Engineering-Capstone-TTE-Communications/TTE_Communications/GUI/Utilities/butts.png

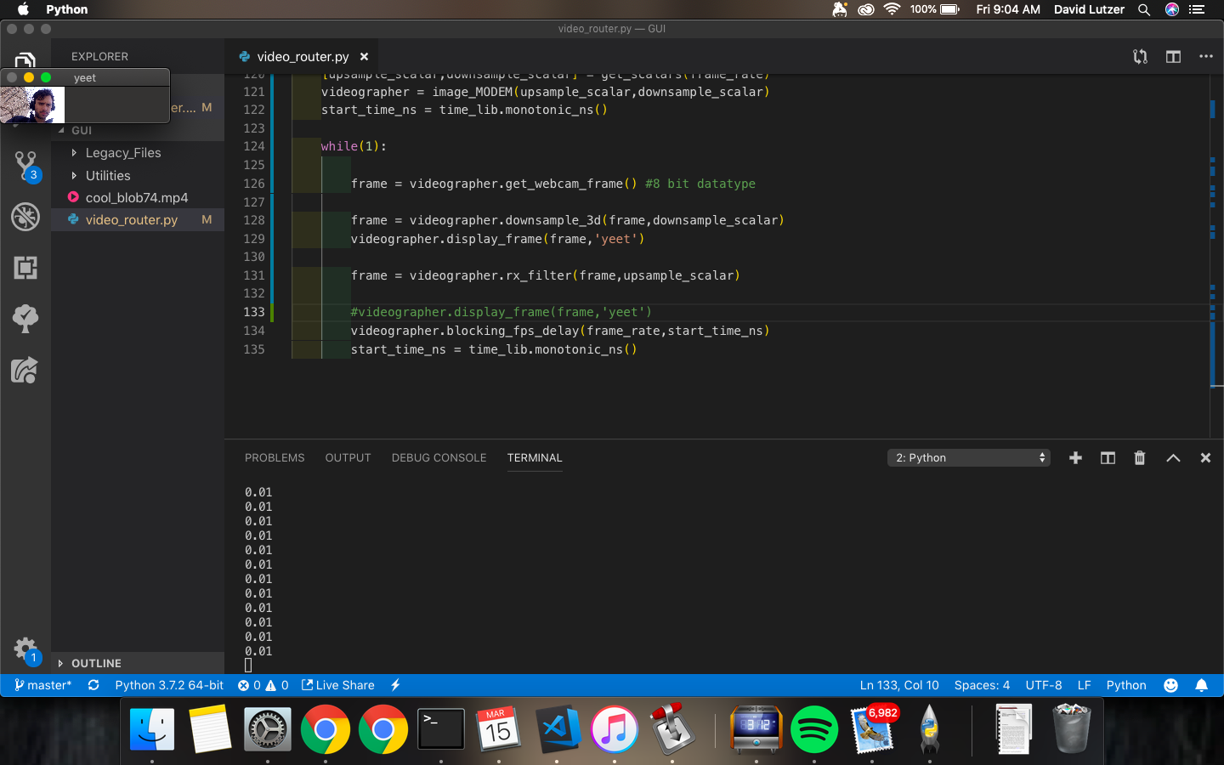
GUI/Utilities/butts.png
