Engineering-Capstone-TTE-Communications/TTE_Communications/GUI/Utilities/download.jpeg

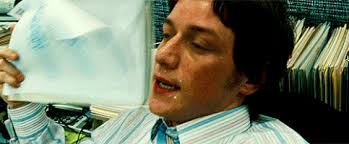
GUI/Utilities/download.jpeg
