Engineering-Capstone-TTE-Communications/TTE_Communications/MODEM_Code/arduino/ADC_Example.ino/aaa.bmp

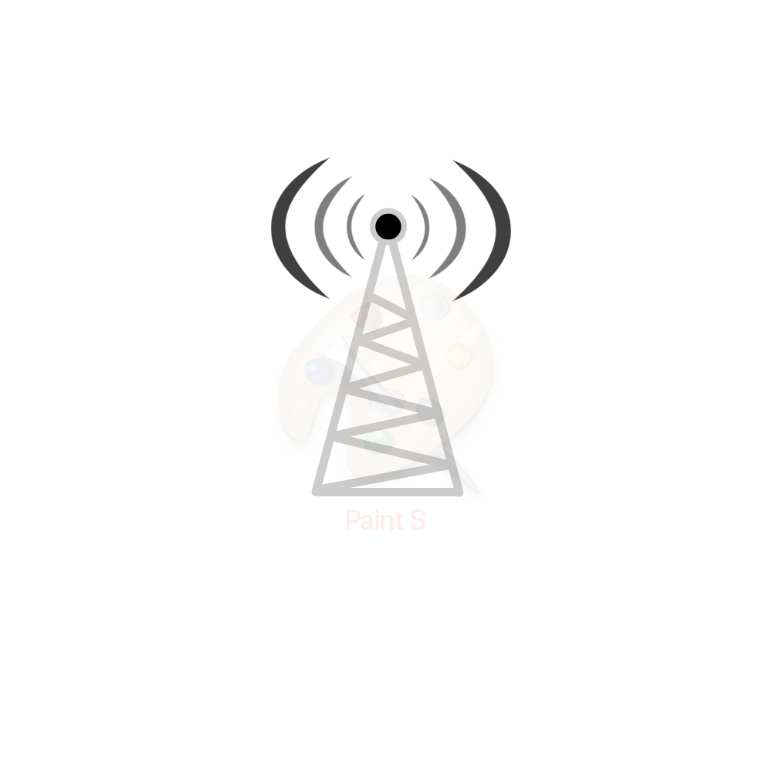
MODEM_Code/arduino/ADC_Example.ino/aaa.bmp
