Engineering-Capstone-TTE-Communications/TTE_Communications/MODEM_Code/arduino/ADC_Example.ino/ADC_DAC_Circuit.jpg

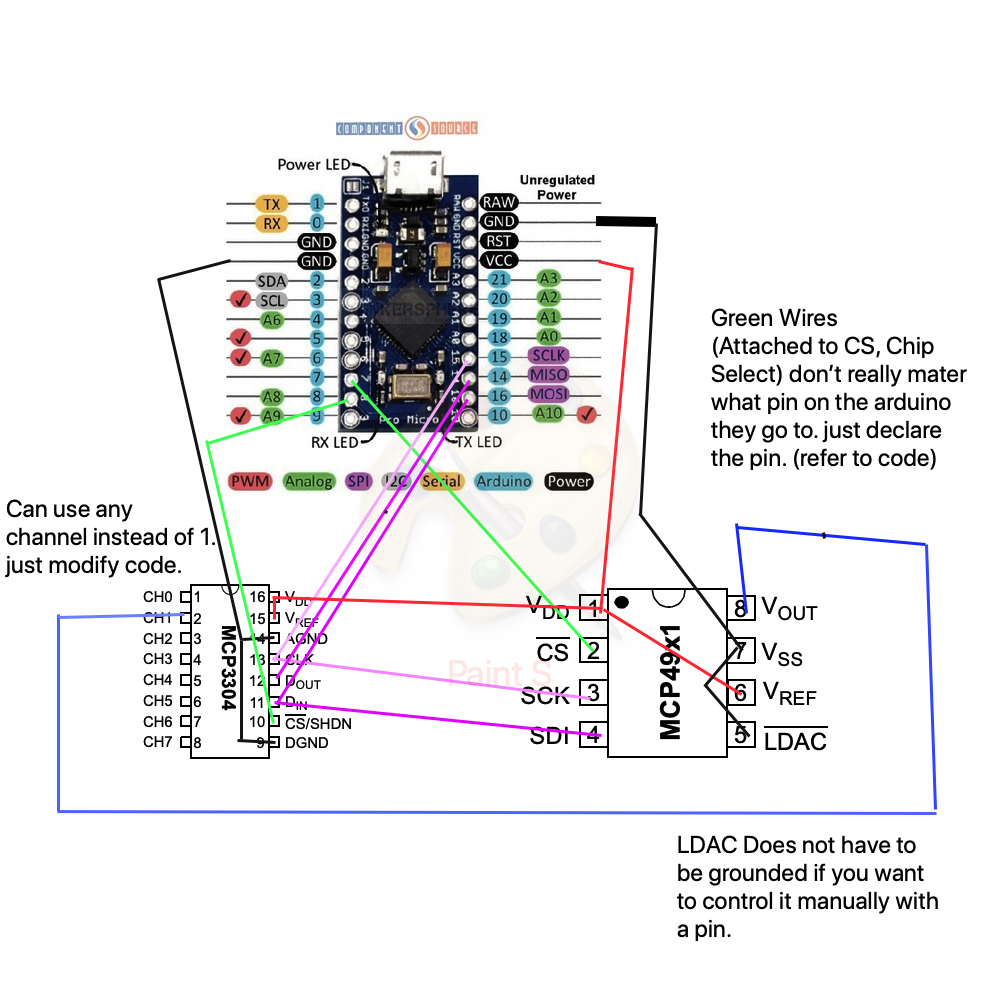
MODEM_Code/arduino/ADC_Example.ino/ADC_DAC_Circuit.jpg
