Engineering-Capstone-TTE-Communications/TTE_Communications/MODEM_Code/MSP/References/datatypes.png

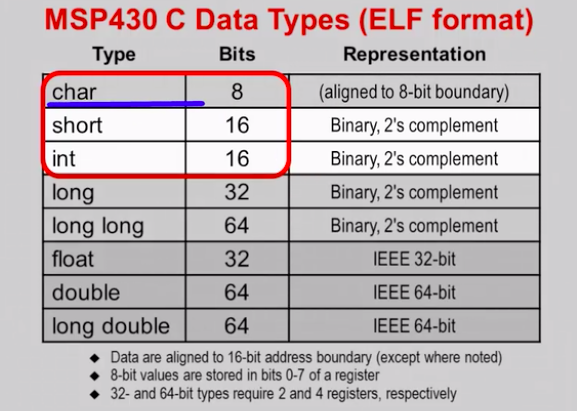
MODEM_Code/MSP/References/datatypes.png
