Engineering-Capstone-TTE-Communications/TTE_Communications/MODEM_Code/MSP/References/download.png

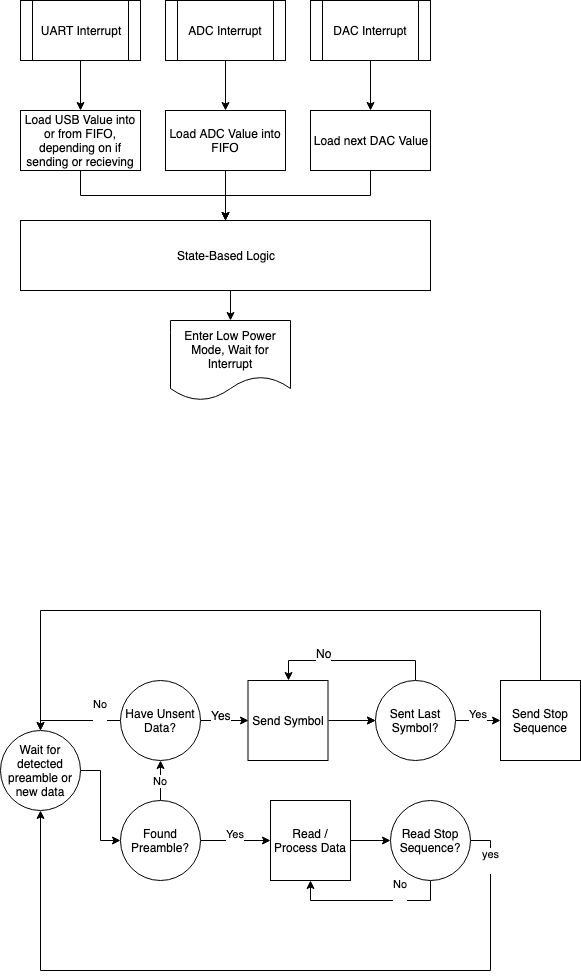
MODEM_Code/MSP/References/download.png
