Engineering-Capstone-TTE-Communications/TTE_Communications/References/Timing Reliability Study/logs/Sampling Rate Density via Dedicated macbook.png

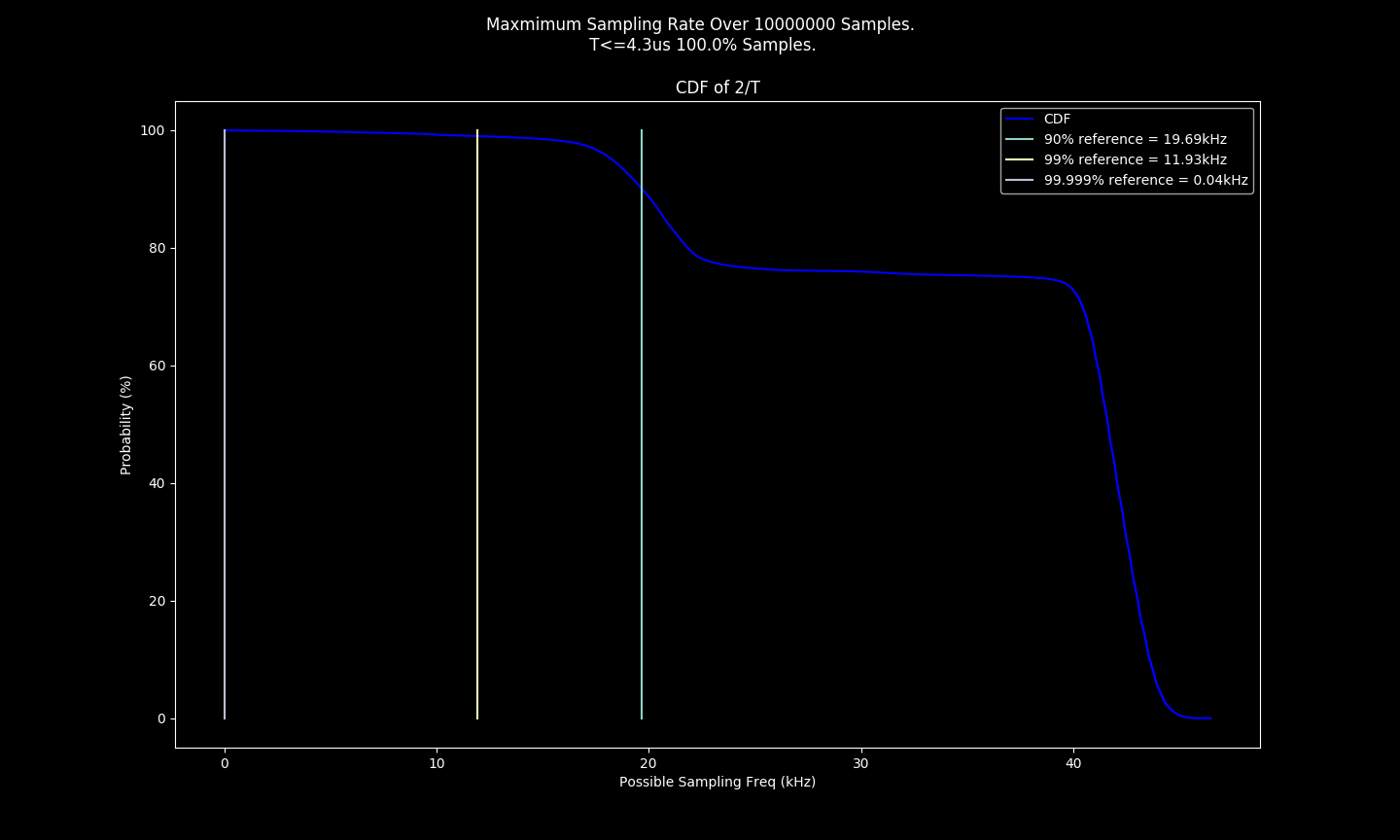
References/Timing Reliability Study/logs/Sampling Rate Density via Dedicated macbook.png
