Engineering-Capstone-TTE-Communications/TTE_Communications/MODEM_Code/arduino/Simulations/dac_adc_exploration_benchmarks/dac_adc_performance_exploration.pdf

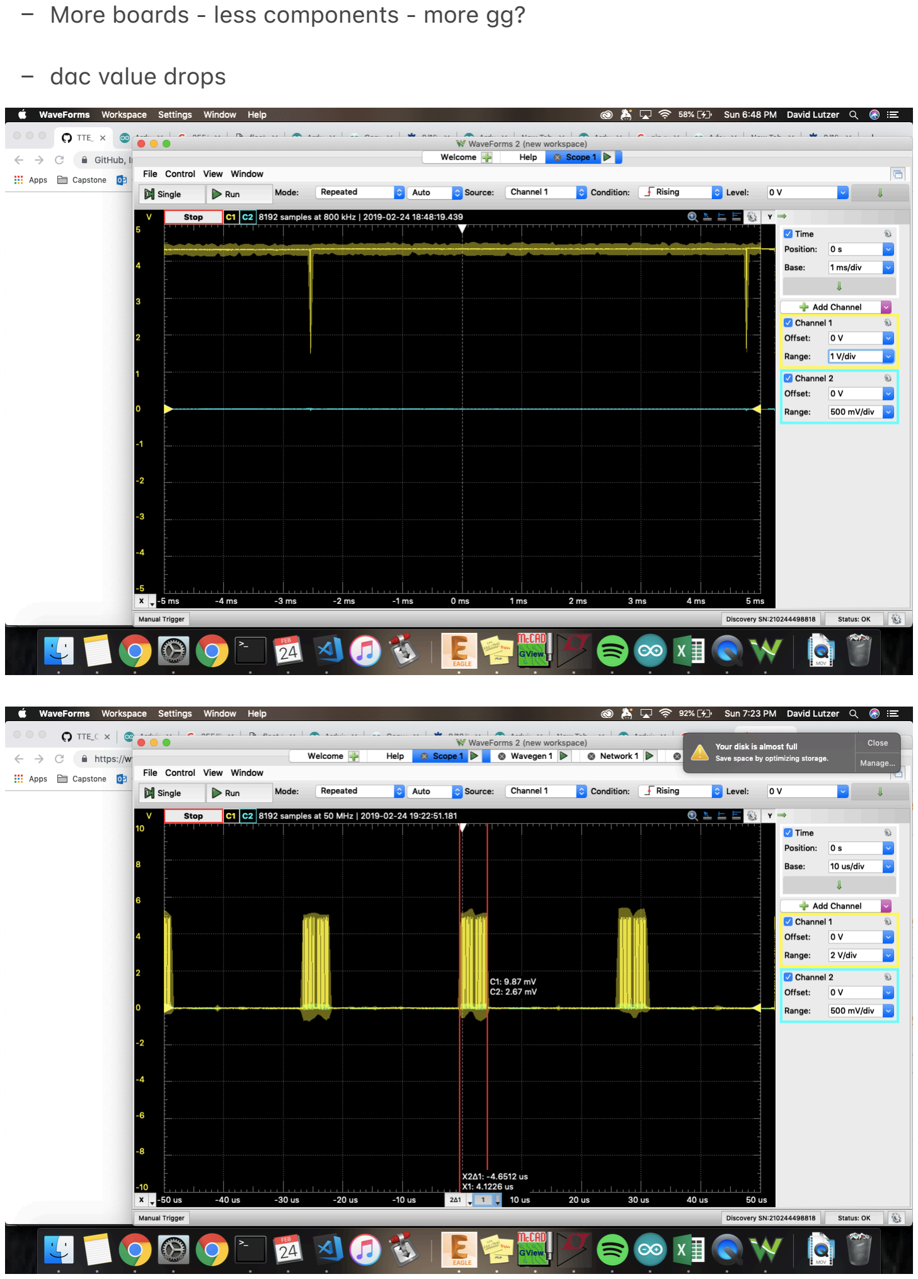
[picture p10: page 1]

–

–

More bo(rds - less components - more gg?

d(c v(lue drops

–
–

–
–
–
–

The spi clk on the DAC using pro mini 16 MHz,
no clock divisor
e.g. we held b(ck by coding qu(lity lm(oooo

2 1 byte tr(ns(ctions completed within 4.65 us 1/4.65us = ~212kHz
Just using spi isnʼt holding us b(ck

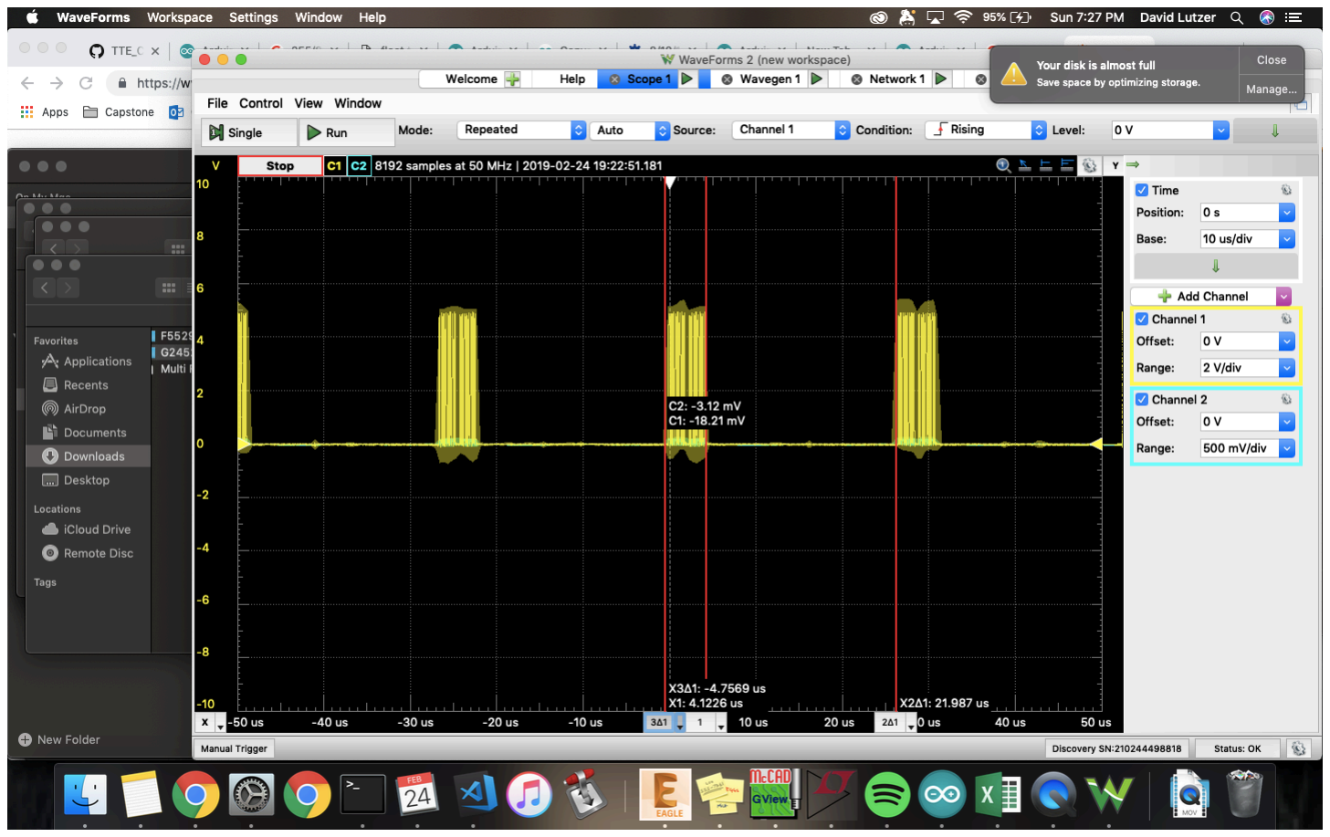
[picture p11: figure]

5x downtime during the bre(ks….
like nothing h(ppens in those bre(ks too… wow

upd(ting d(c, it spikes for ( hot sec, this c(n be weird for inductor so c(p pls :)

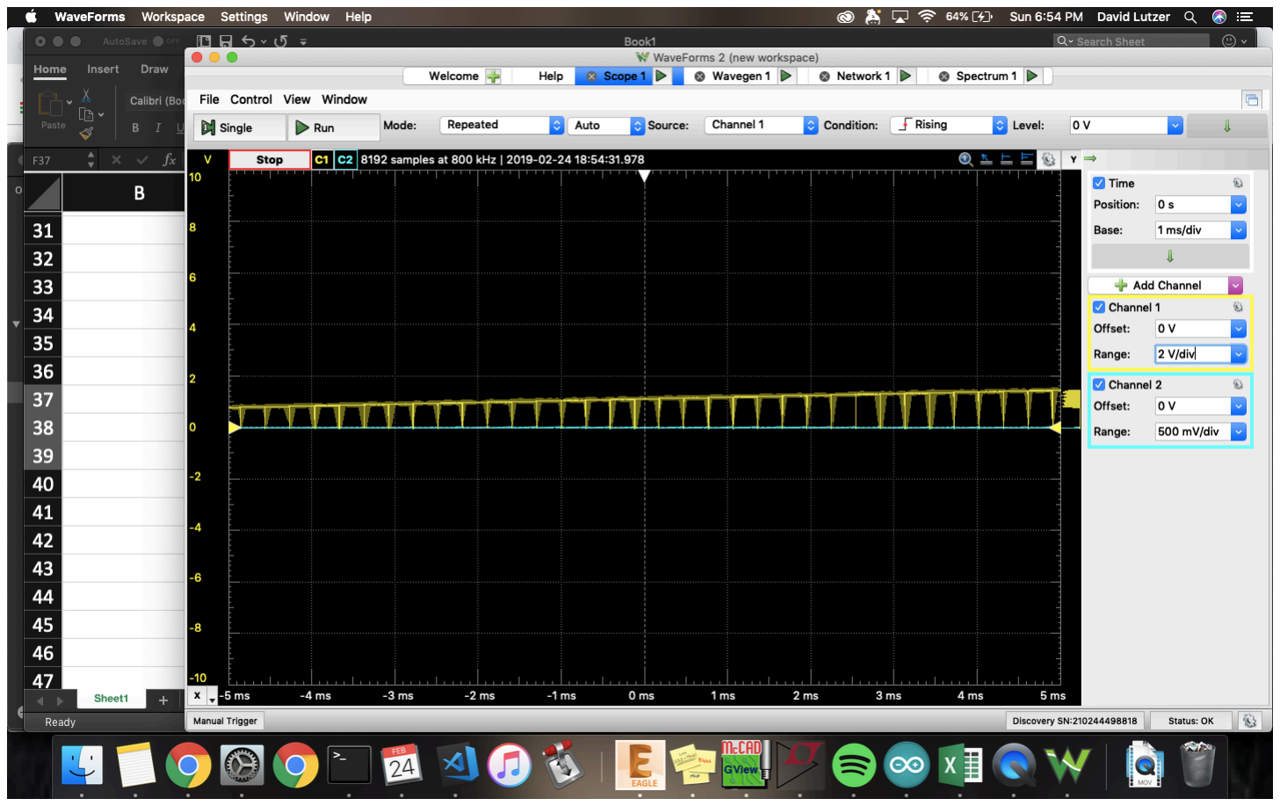
[picture p12: figure]
