Engineering-Capstone-TTE-Communications/TTE_Communications/Hardware/Utilities/Simulations/current_driven_antenna_no_esd.asc

D3: diode
D4: diode
I1: current; SINE(0 .02 8k)
L1: ind; 1; Rser=1
V1: voltage; SINE(0 5 8000)
Named nets: 0
.tran .001
