Engineering-Capstone-TTE-Communications/TTE_Communications/Hardware/CAD-eagle/prototype_total_schematic_2355.brd

## EAGLE design Hardware/CAD-eagle/prototype_total_schematic_2355.brd (2019-06-28)

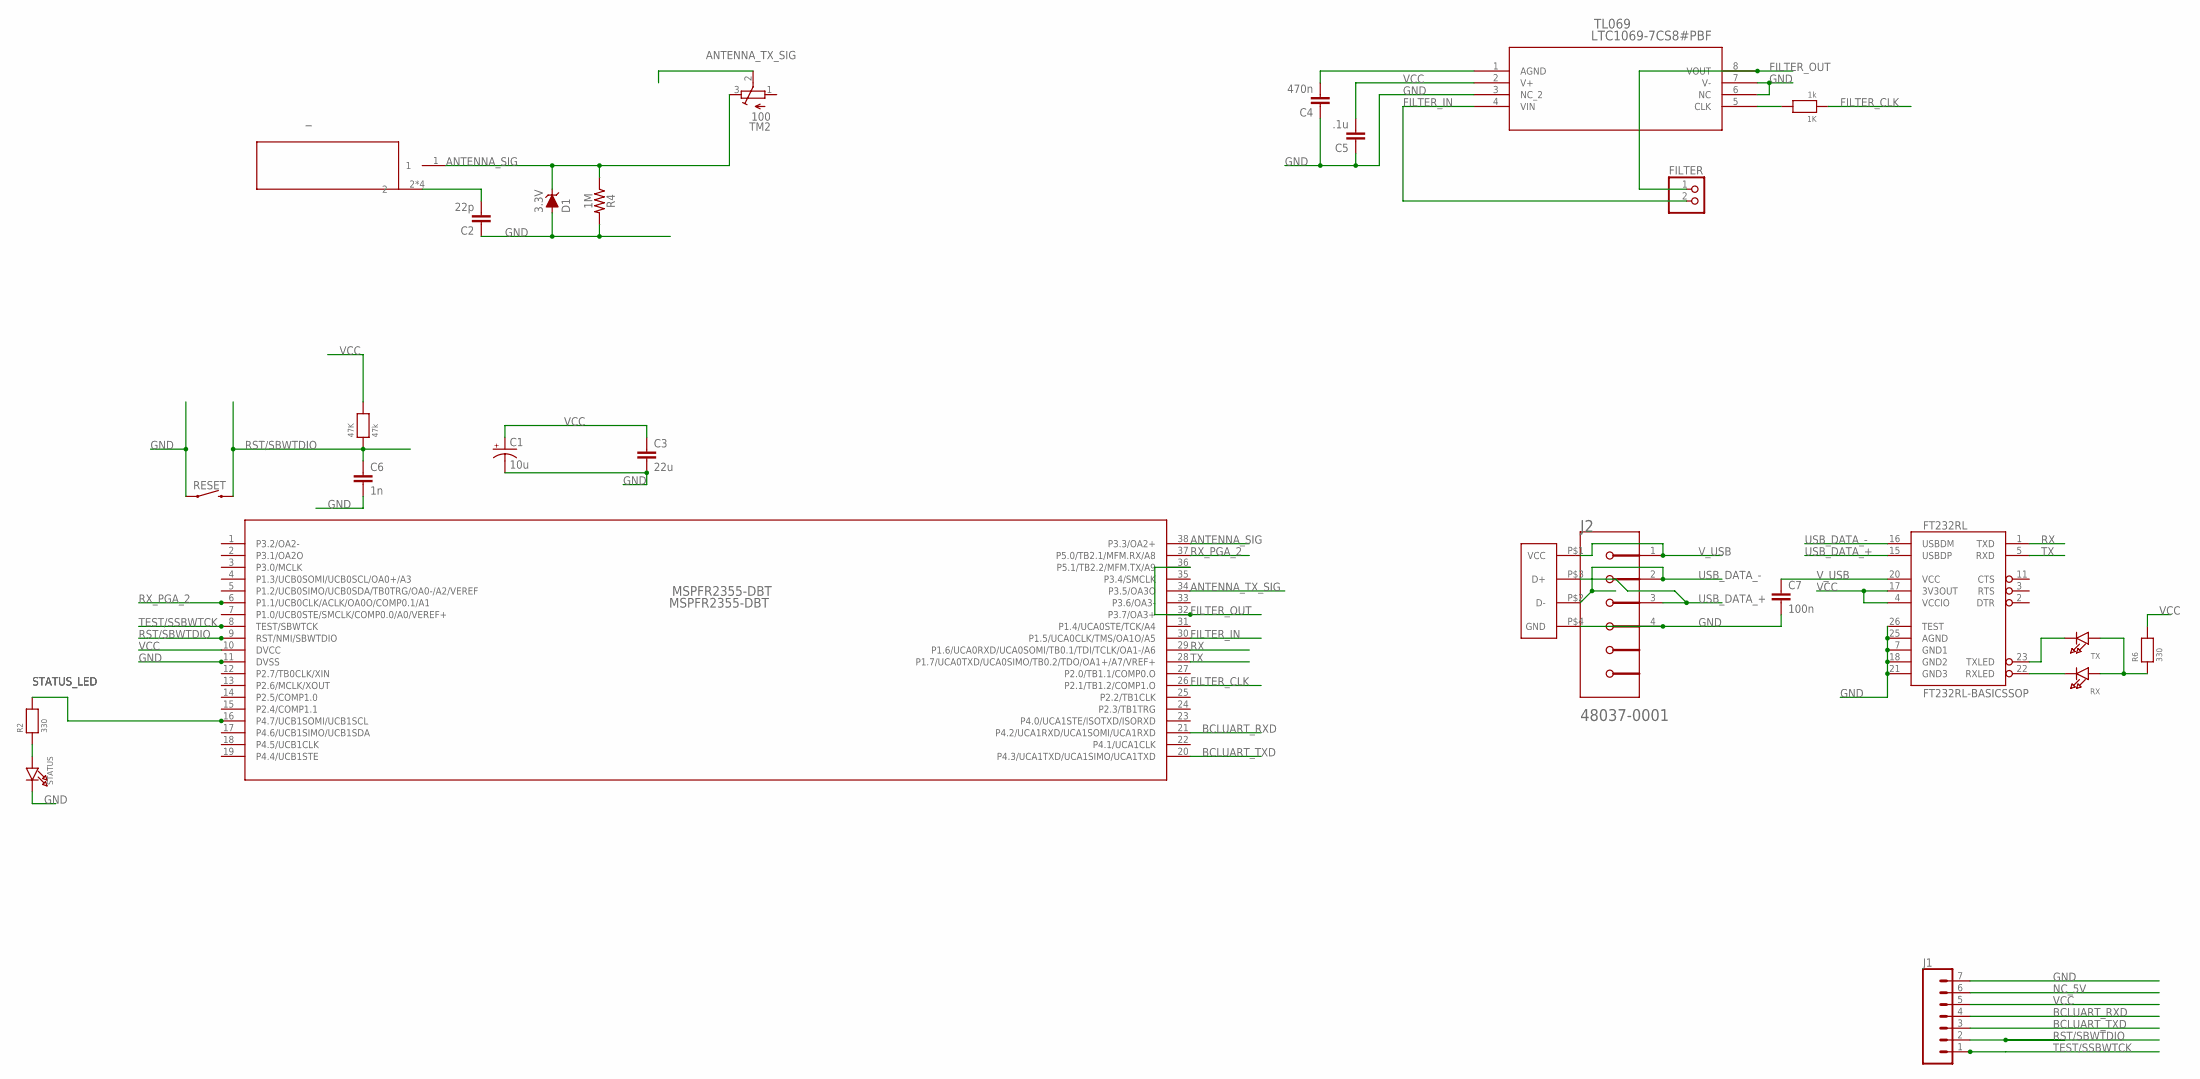
[picture p13: schematic prototype_total_schematic_2355.sch, Peripherals]

Parts:
1K: 1k; 0805
47K: 47k; 0805
C1: 10u; EIA6032-NOM
C2: 22p; 0805
C3: 22u; 0805
C4: 470n; 0805
C5: .1u; 0805
C6: 1n; 0805
C7: 100n; 0805
D1: 3.3V; SOD-323
FILTER: HEADER-1X2ROUND; 1X02_ROUND
FT232RL: FT232RL-BASICSSOP; SSOP28DB
J1: CONN_07NO_SILK; 1X07_NO_SILK
J2: MOLEX_48037-0001MOLEX_48037-0001_0_0; MOLEX_48037-0001_0
MSPFR2355-DBT: MSPFR2355-DBT; SOP50P640X120-38N
R2, R6: 330; 0805
R4: 1M; 0603
RESET: MOMENTARY-SWITCH-SPST-PTH-6.0MM; TACTILE_SWITCH_PTH_6.0MM
RX: LED0805; CHIPLED_0805
STATUS: LED0805; CHIPLED_0805
TL069: LTC1069-7CS8#PBF; SO-8_S
TM2: 100; TC33X
TX: LED0805; CHIPLED_0805
U$1: USB-PCB; PCB_USB
_: 5-1814400-1

Connections:
ANTENNA_SIG: D1.C, MSPFR2355-DBT.38 (P3.3/OA2+), R4.1, TM2.3 (E), _.1
ANTENNA_TX_SIG: MSPFR2355-DBT.34 (P3.5/OA3O), TM2.2 (S)
BCLUART_RXD: J1.4, MSPFR2355-DBT.21 (P4.2/UCA1RXD/UCA1SOMI/UCA1RXD)
BCLUART_TXD: J1.3, MSPFR2355-DBT.20 (P4.3/UCA1TXD/UCA1SIMO/UCA1TXD)
FILTER_CLK: 1K.1, MSPFR2355-DBT.26 (P2.1/TB1.2/COMP1.O)
FILTER_IN: FILTER.2, MSPFR2355-DBT.30 (P1.5/UCA0CLK/TMS/OA1O/A5), TL069.4 (VIN)
FILTER_OUT: FILTER.1, MSPFR2355-DBT.32 (P3.7/OA3+), MSPFR2355-DBT.36 (P5.1/TB2.2/MFM.TX/A9), TL069.8 (VOUT)
GND: C1.C (-), C2.1, C3.2, C4.1, C5.1, C6.2, C7.2, D1.A, FT232RL.7 (GND1), FT232RL.18 (GND2), FT232RL.21 (GND3), FT232RL.25 (AGND), FT232RL.26 (TEST), J1.7, J2.4, MSPFR2355-DBT.11 (DVSS), R4.2, RESET.1, STATUS.C, TL069.3 (NC_2), TL069.6 (NC), TL069.7 (V-), U$1.P$4 (GND)
unnamed: 1K.2, TL069.5 (CLK)
unnamed: C2.2, _.2, _.3 (2), _.4 (2), _.5 (2)
unnamed: C4.2, TL069.1 (AGND)
unnamed: R2.1, STATUS.A
unnamed: FT232RL.22 (RXLED), RX.C
unnamed: FT232RL.23 (TXLED), TX.C
unnamed: R6.1, RX.A, TX.A
NC_5V: J1.6
P1.3/UCB0SOMI/UCB0SCL/OA0+/A3: MSPFR2355-DBT.4 (P1.3/UCB0SOMI/UCB0SCL/OA0+/A3)
P3.0/MCLK: MSPFR2355-DBT.3 (P3.0/MCLK)
P3.6/OA3-: MSPFR2355-DBT.33 (P3.6/OA3-)
RST/SBWTDIO: 47K.1, C6.1, J1.2, MSPFR2355-DBT.9 (RST/NMI/SBWTDIO), RESET.3 (2)
RX: FT232RL.1 (TXD), MSPFR2355-DBT.29 (P1.6/UCA0RXD/UCA0SOMI/TB0.1/TDI/TCLK/OA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)
RX_PGA_2: MSPFR2355-DBT.6 (P1.1/UCB0CLK/ACLK/OA0O/COMP0.1/A1), MSPFR2355-DBT.37 (P5.0/TB2.1/MFM.RX/A8)
STATUS_LED: MSPFR2355-DBT.16 (P4.7/UCB1SOMI/UCB1SCL), R2.2
TEST/SSBWTCK: J1.1, MSPFR2355-DBT.8 (TEST/SBWTCK)
TX: FT232RL.5 (RXD), MSPFR2355-DBT.28 (P1.7/UCA0TXD/UCA0SIMO/TB0.2/TDO/OA1+/A7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)
USB_DATA_+: FT232RL.15 (USBDP), J2.3, U$1.P$3 (D+)
USB_DATA_-: FT232RL.16 (USBDM), J2.2, U$1.P$2 (D-)
VCC: 47K.2, C1.A (+), C3.1, C5.2, FT232RL.4 (VCCIO), FT232RL.17 (3V3OUT), J1.5, MSPFR2355-DBT.10 (DVCC), R6.2, TL069.2 (V+)
V_USB: C7.1, FT232RL.20 (VCC), J2.1, U$1.P$1 (VCC)

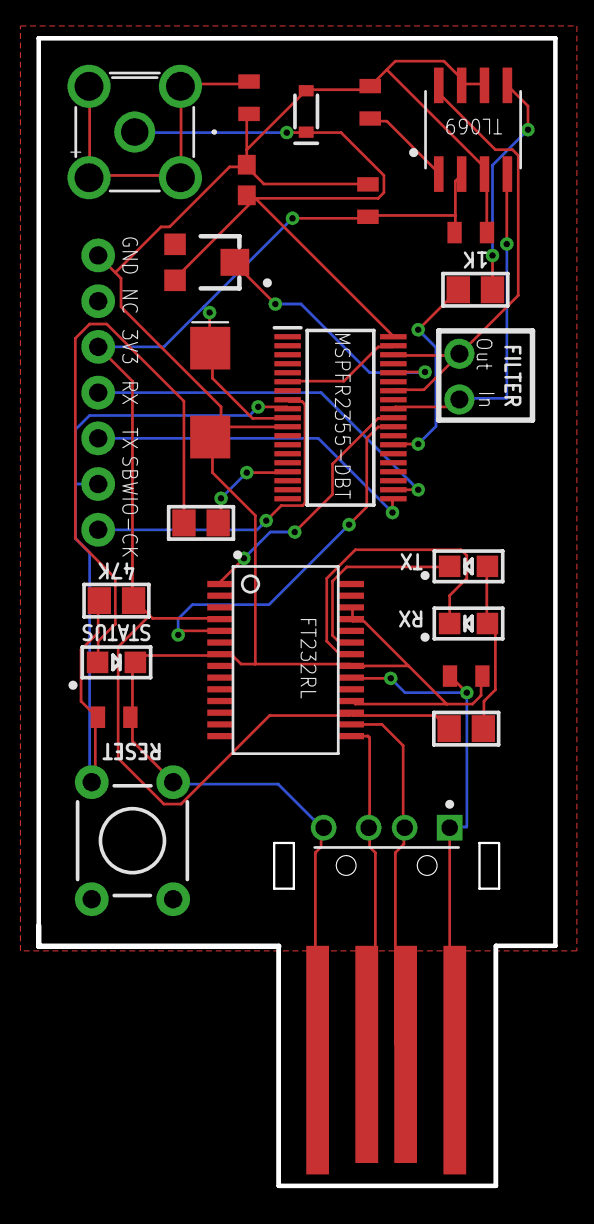
[picture p14: board prototype_total_schematic_2355.brd from above]

Board: 2 copper layers, 28.7 x 63.8 mm, 26 parts (0 on the bottom side), 25 nets.
