Engineering-Capstone-TTE-Communications/TTE_Communications/MODEM_Code/MSP/QmathLib_signal_FFT_ex4_MPYsoftware/sine.h

/*
 * sine.h
 *
 *  Created on: Mar 18, 2019
 *      Author: donald
 */

#ifndef SINE_H_
#define SINE_H_


#define LUT_count_first_to_last 0
#define LUT_count_last_to_first 1
#define LUT_count_first_to_last_inv 2
#define LUT_count_last_to_first_inv 3

//sine_fc_8000_Fs_2500
//Downsampled by a factor of 0
#define negative_LUT_element_offset 2048


unsigned int sine_LUT[] = {
0,5,10,15,21,26,31,36,41,46,
    52,57,62,67,72,77,82,88,93,98,
    103,108,113,118,124,129,134,139,144,149,
    154,160,165,170,175,180,185,190,196,201,
    206,211,216,221,226,231,237,242,247,252,
    257,262,267,272,277,283,288,293,298,303,
    308,313,318,323,328,334,339,344,349,354,
    359,364,369,374,379,384,389,394,399,405,
    410,415,420,425,430,435,440,445,450,455,
    460,465,470,475,480,485,490,495,500,505,
    510,515,520,525,530,535,540,545,550,555,
    560,565,570,575,580,584,589,594,599,604,
    609,614,619,624,629,634,639,643,648,653,
    658,663,668,673,678,682,687,692,697,702,
    707,712,716,721,726,731,736,740,745,750,
    755,760,764,769,774,779,784,788,793,798,
    803,807,812,817,821,826,831,836,840,845,
    850,854,859,864,868,873,878,882,887,892,
    896,901,906,910,915,919,924,929,933,938,
    942,947,952,956,961,965,970,974,979,983,
    988,992,997,1001,1006,1010,1015,1019,1024,1028,
    1033,1037,1042,1046,1050,1055,1059,1064,1068,1072,
    1077,1081,1086,1090,1094,1099,1103,1107,1112,1116,
    1120,1125,1129,1133,1138,1142,1146,1150,1155,1159,
    1163,1167,1172,1176,1180,1184,1188,1193,1197,1201,
    1205,1209,1213,1218,1222,1226,1230,1234,1238,1242,
    1246,1251,1255,1259,1263,1267,1271,1275,1279,1283,
    1287,1291,1295,1299,1303,1307,1311,1315,1319,1323,
    1327,1331,1334,1338,1342,1346,1350,1354,1358,1362,
    1365,1369,1373,1377,1381,1385,1388,1392,1396,1400,
    1403,1407,1411,1415,1418,1422,1426,1429,1433,1437,
    1440,1444,1448,1451,1455,1459,1462,1466,1470,1473,
    1477,1480,1484,1487,1491,1494,1498,1501,1505,1508,
    1512,1515,1519,1522,1526,1529,1533,1536,1539,1543,
    1546,1550,1553,1556,1560,1563,1566,1570,1573,1576,
    1579,1583,1586,1589,1593,1596,1599,1602,1605,1609,
    1612,1615,1618,1621,1624,1628,1631,1634,1637,1640,
    1643,1646,1649,1652,1655,1658,1661,1664,1667,1670,
    1673,1676,1679,1682,1685,1688,1691,1694,1697,1700,
    1702,1705,1708,1711,1714,1717,1719,1722,1725,1728,
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
};

#endif /* SINE_H_ */
