Engineering-Capstone-TTE-Communications/TTE_Communications/(commit log)

2019-01-26 Adding GUI Progress, Audio-BFSK reciever
    [resistors.csv]
2019-02-10 Working ADC code, for reference.
2019-02-10 Working adc-dac connection
2019-02-10 Including circuit schematic
2019-02-20 Including initial hardware design files
    [prototype_total_schematic.sch, transciever_test_schematic.sch]
2019-02-26 Latest hardware revisions
    [prototype_total_schematic.sch, prototype_total_schematic_2355.sch, prototype_total_schematic_3.sch, prototype_total_schematic_60431.sch, prototype_total_schematic_n.sch, prototype_total_schematic_n2.sch, prototype_total_schematic_ultasonic.sch, resistors.csv]
2019-02-27 Nightly Update
    [prototype_total_schematic.sch, prototype_total_schematic_2355.sch, prototype_total_schematic_3.sch, prototype_total_schematic_60431.sch, prototype_total_schematic_n.sch, prototype_total_schematic_n2.sch, prototype_total_schematic_ultasonic.sch, transciever_test_schematic.sch]
2019-02-28 Nightly build. Hopefully final version.
    [prototype_total_schematic_2355.brd, prototype_total_schematic_2355.sch]
2019-03-03 MSP430 Initial Code, Serial Port Echo Code
    [prototype_total_schematic_2355.brd, prototype_total_schematic_2355.sch]
2019-03-05 Submitted orderss. finally. :)
    [BOM.csv, prototype_total_schematic_2355.brd, prototype_total_schematic_2355.csv, prototype_total_schematic_2355.sch, prototype_total_schematic_2355s.brd, prototype_total_schematic_2355ss.brd]
2019-03-07 PGA Stage 2 Working
    [BOM.csv]
2019-03-07 Cascaded RX PGA array confirmed
    [prototype_total_schematic_2355.brd, prototype_total_schematic_2355.sch]
2019-03-08 Reciever Pipeline Confirmed, Updated Gerbers, included tx coupling capacitor for rx offset
    [prototype_total_schematic_2355.brd, prototype_total_schematic_2355.sch]
2019-03-12 MODEM Files
    [prototype_total_schematic_2355.brd, prototype_total_schematic_2355.sch, prototype_total_schematic_2355_Depricated.brd, prototype_total_schematic_2355s.brd]
2019-03-12 Working PWM TB2.2
2019-03-14 Filter Clock Practical Usage Verification
2019-03-14 PWM DAC Confirmed. 3v3 Logic Filter Confirmed -> need to decouple agnd
2019-03-15 Switched to a class structure
2019-03-22 cooler dac
    [adc.obj, crc.obj, cs.obj, ecomp.obj, eusci_a_spi.obj, eusci_a_uart.obj, eusci_b_i2c.obj, eusci_b_spi.obj]
2019-03-22 cooler adc
2019-03-25 approx 1 in 3800 error rate 0 SNR
    [main.c]
2019-03-25 Re-integrating filter
2019-04-15 V3 PCB schematics Ordered
    [prototype_total_schematic_2355.brd, prototype_total_schematic_2355.sch]
2019-04-21 50kHz sampline, adc dac sync
2019-04-24 Presentable Master Branch
    [BOM.csv, adc.obj, crc.obj, cs.obj, ecomp.obj, eusci_a_spi.obj, eusci_a_uart.obj, eusci_b_i2c.obj]
